AGorshkov101/RainDrop-Gaming-Keypad/README.md

# RainDrop Ergonomic Gaming Keypad
## Your Controls, Right Where You Need Them.

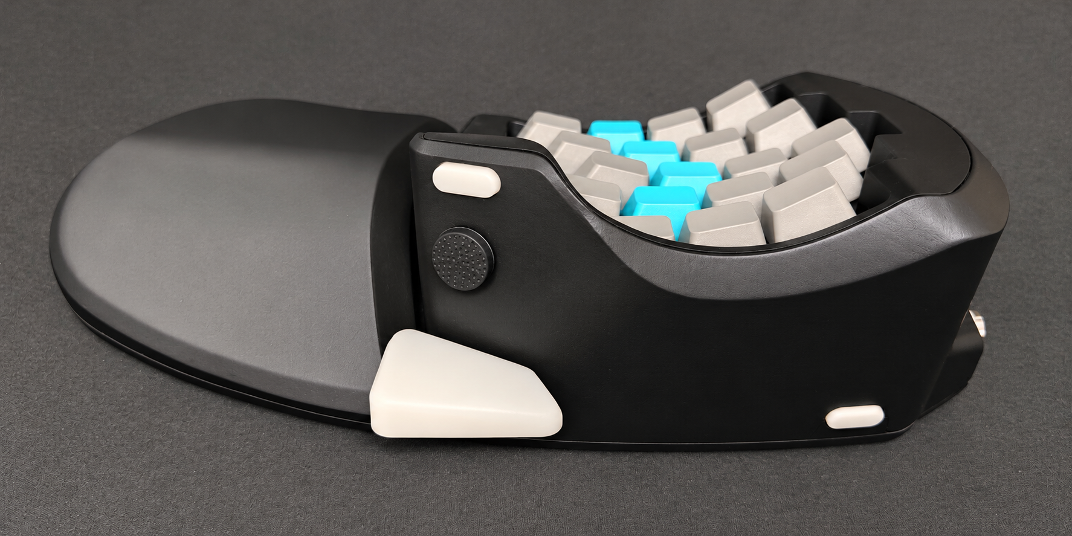
[picture p1: Images/Ergonomic Keypad.png]


**Curved Key Configuration**\
Follows the natural range of motion of your fingers to minimize stretching and keep every key within comfortable reach. 

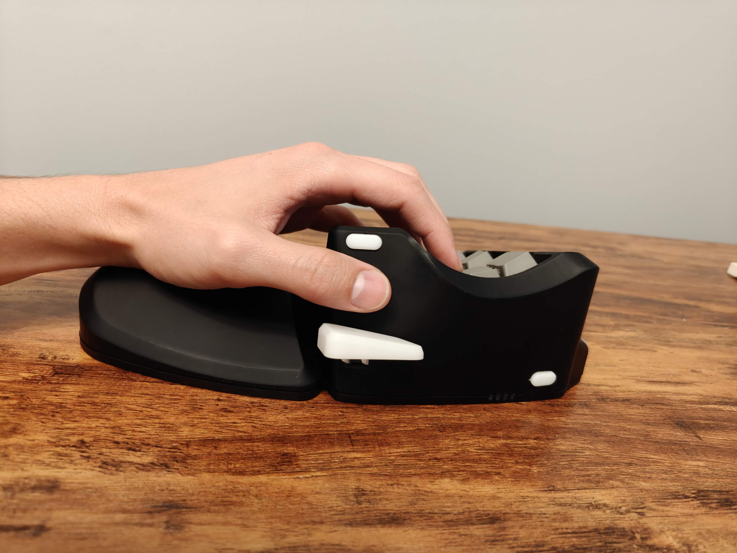
[picture p2: Images/IMG20260822131359.jpg]
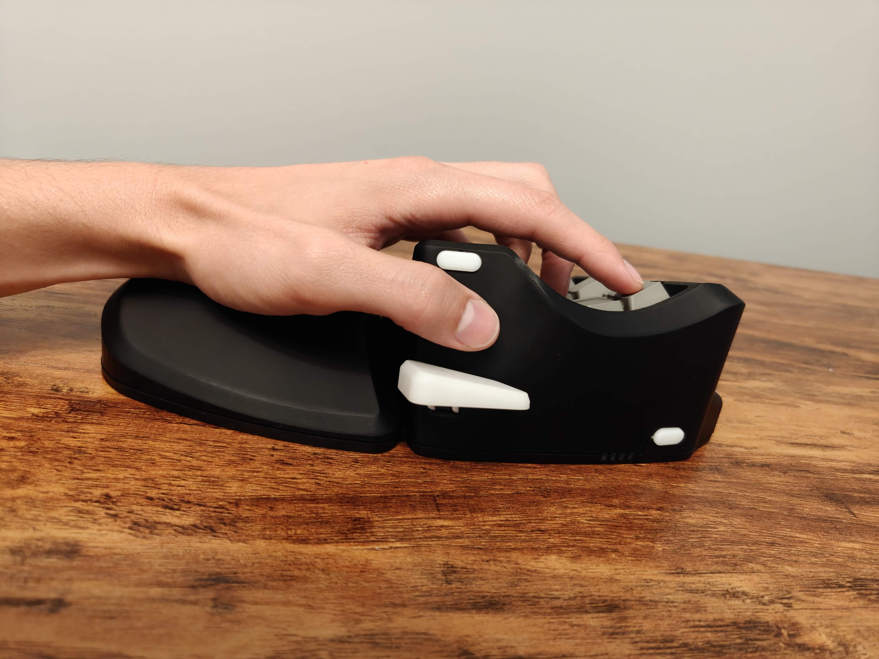
[picture p3: Images/IMG20260822131403.jpg]


**Finger-Aligned Key Layout**\
An intuitive linear layout with keys shifted to match the natural differences in finger length.

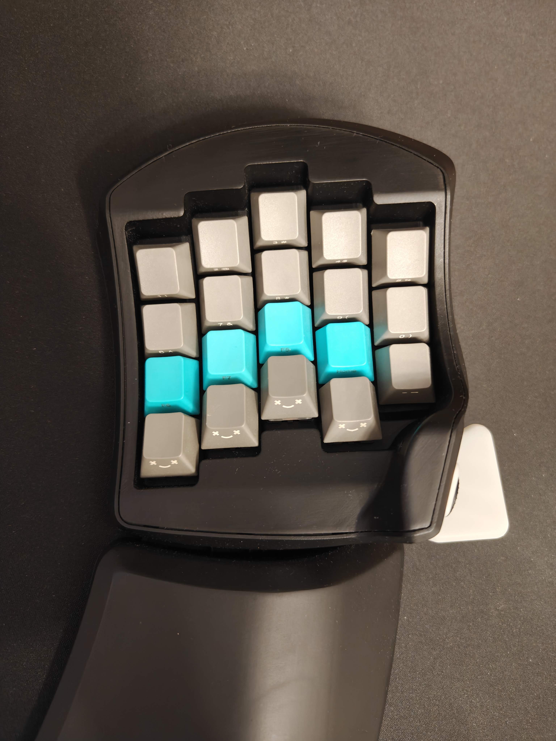
[picture p4: Images/IMG20261107213127.jpg]


**Compact Thumb Cluster**\
Designed to keep thumb keys within natural reach, minimizing excessive stretching to reducing thumb strain. 

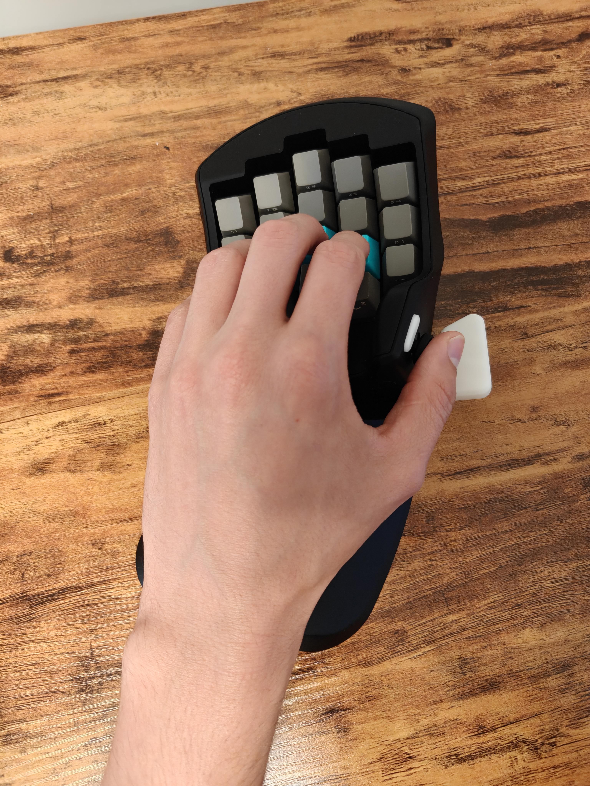
[picture p5: Images/IMG20260822131439.jpg]


**Natural Wrist Position**\
Angled to better align with your neutral wrist position for a more comfortable gaming experience.

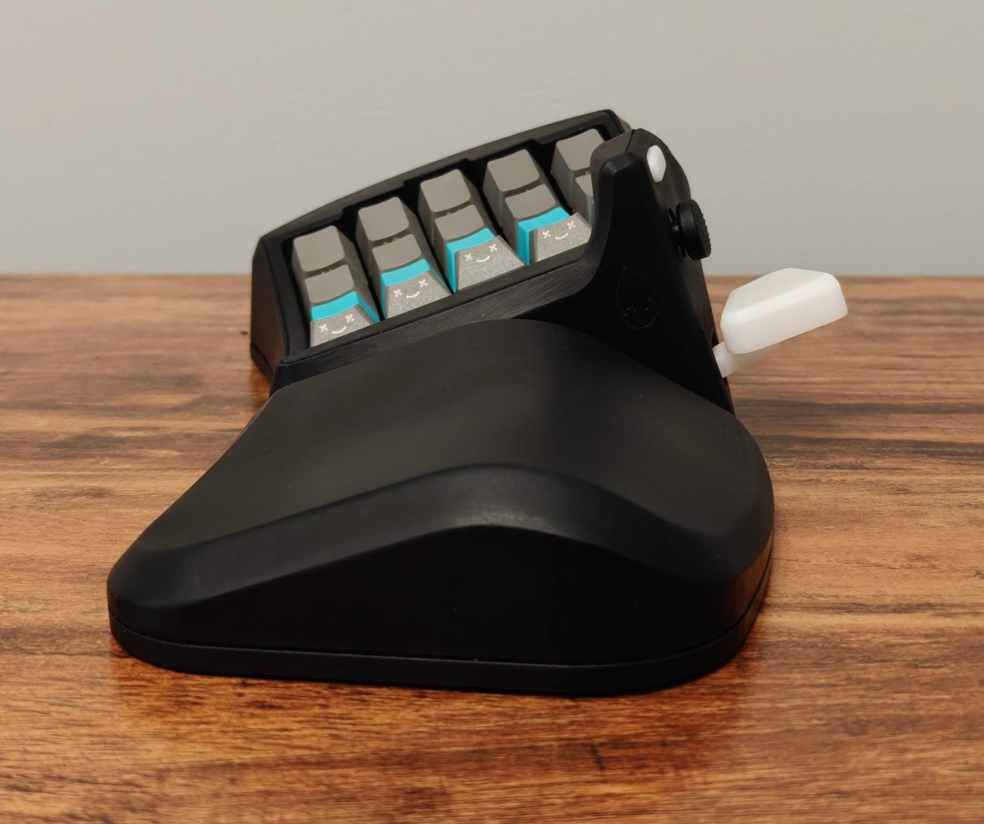
[picture p6: Images/IMG20260822131346.jpg]


**More Room to Aim**\
Compact design frees up valuable mouse space, giving you greater range of motion for low-sensitivity aiming.

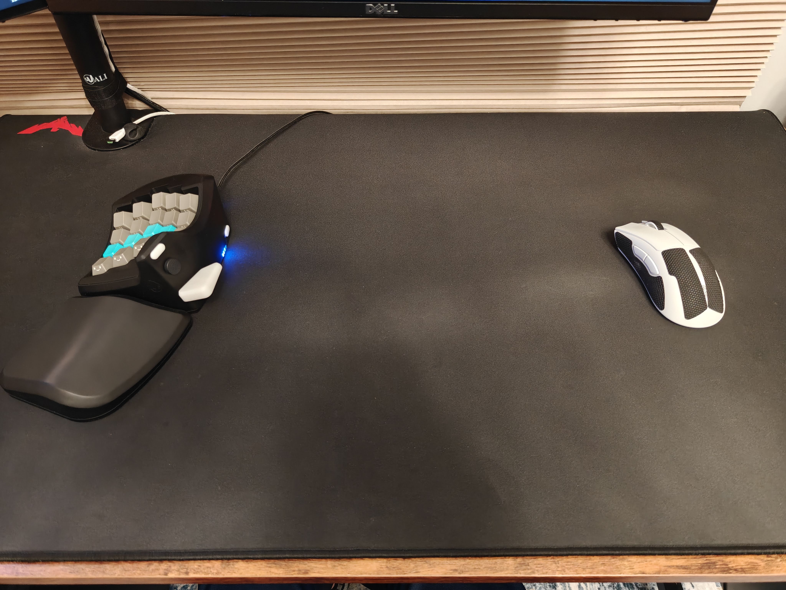
[picture p7: Images/IMG20261107213441.jpg]


**Customizable Mechanical Switches**\
Choose the mechanical switches that match your preferred feel, tactile feedback, and responsiveness.

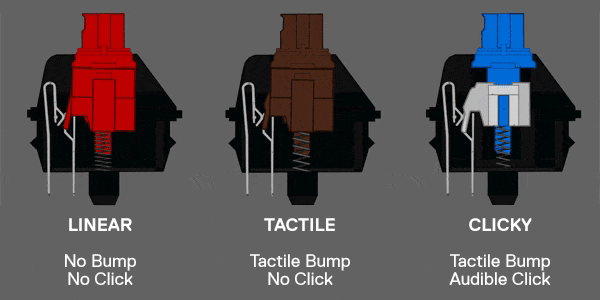
[picture p8: Images/Switch.png]


**Intuitive Configuration Software**\
Easily customize your key layout through a simple PC interface. Save up to four profiles directly to the device.

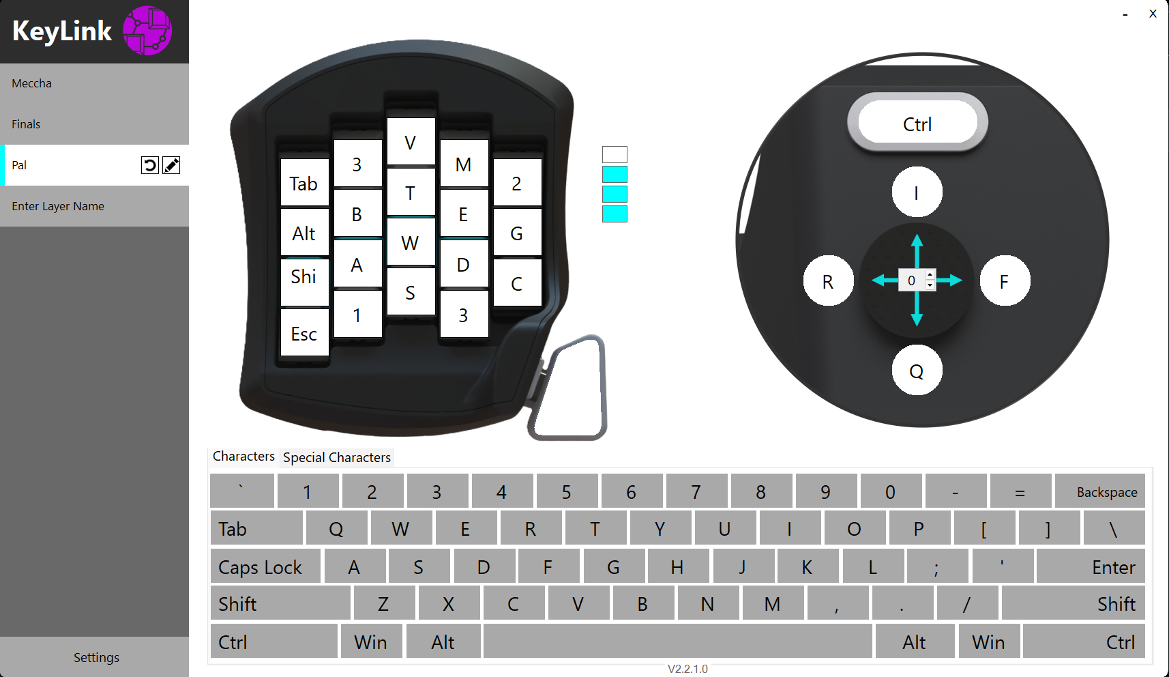
[picture p9: Images/ui.PNG]


**Fully Open Source**\
Make it your own. Explore, modify, customize, and build upon the design with complete access to the source.
