AGorshkov101/RainDrop-Gaming-Keypad/Images/20241106_225428.jpg

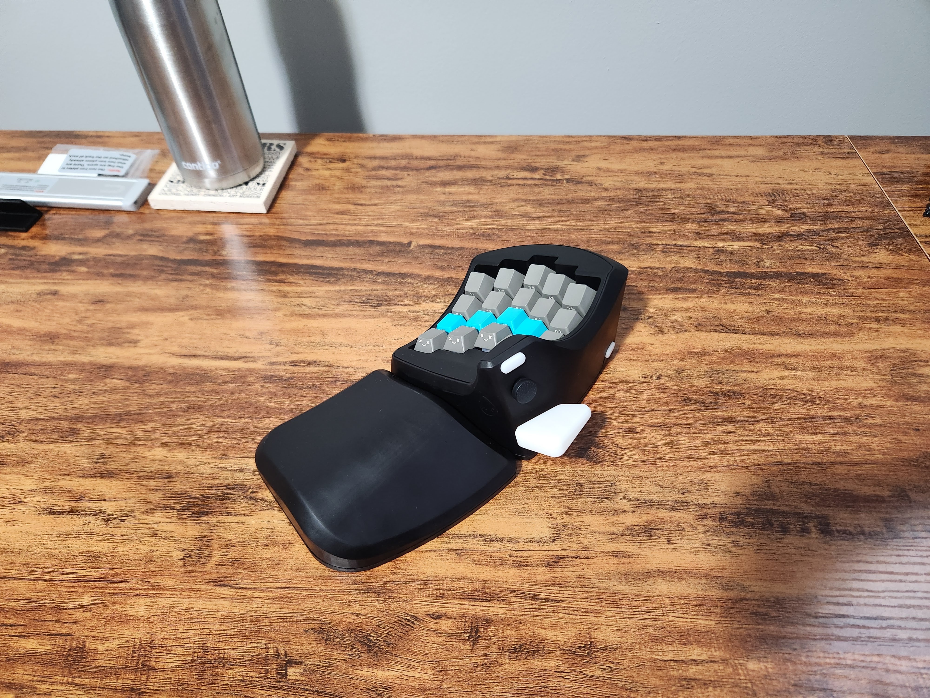
Images/20241106_225428.jpg
