AGorshkov101/RainDrop-Gaming-Keypad/Images/IMG20261107213005.jpg

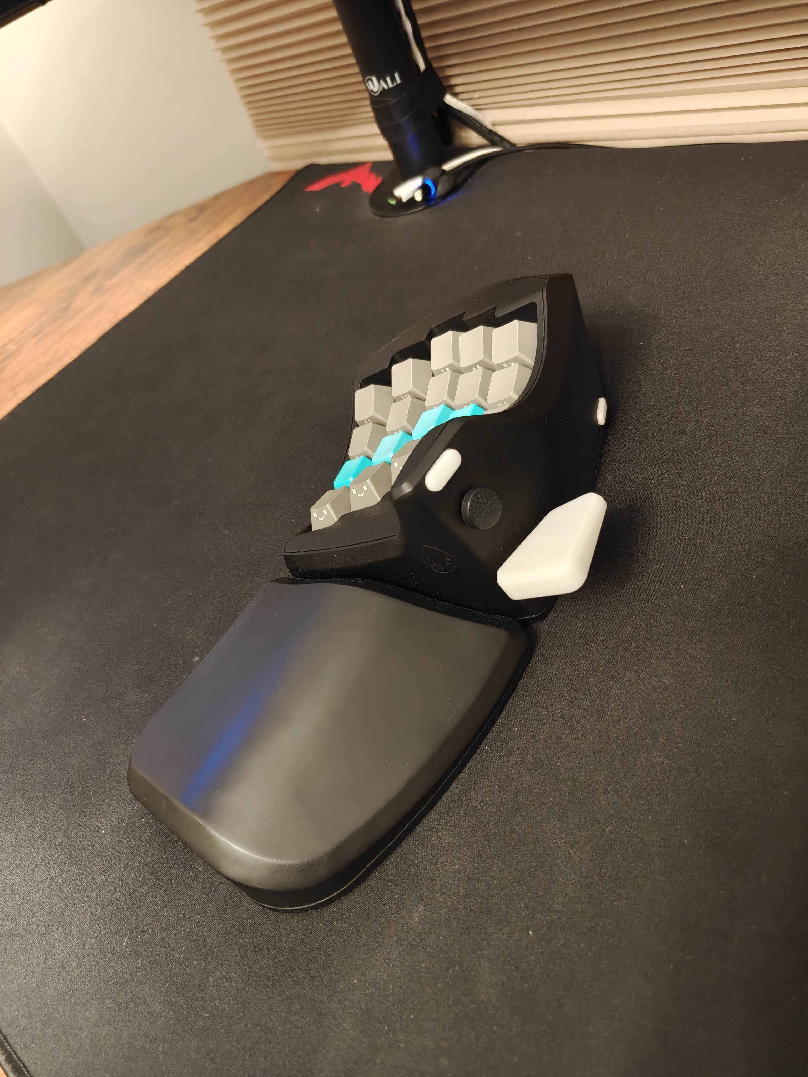
Images/IMG20261107213005.jpg
