AGorshkov101/RainDrop-Gaming-Keypad/Images/IMG20261107214502.jpg

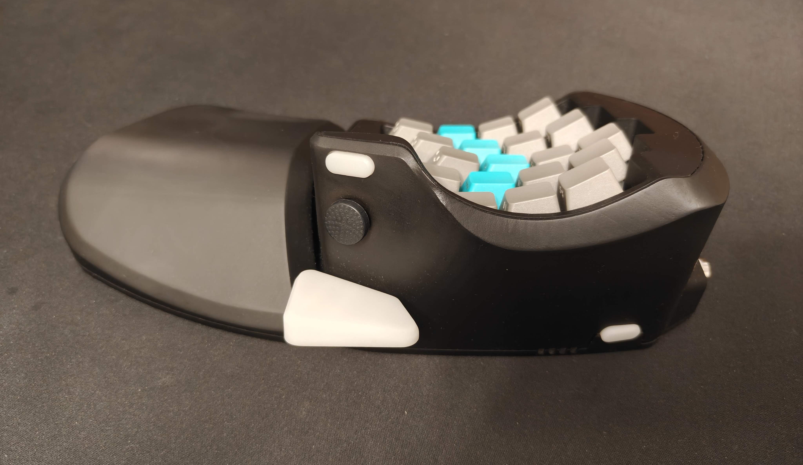
Images/IMG20261107214502.jpg
