AGorshkov101/RainDrop-Gaming-Keypad/Images/IMG_20261107_214522.jpg

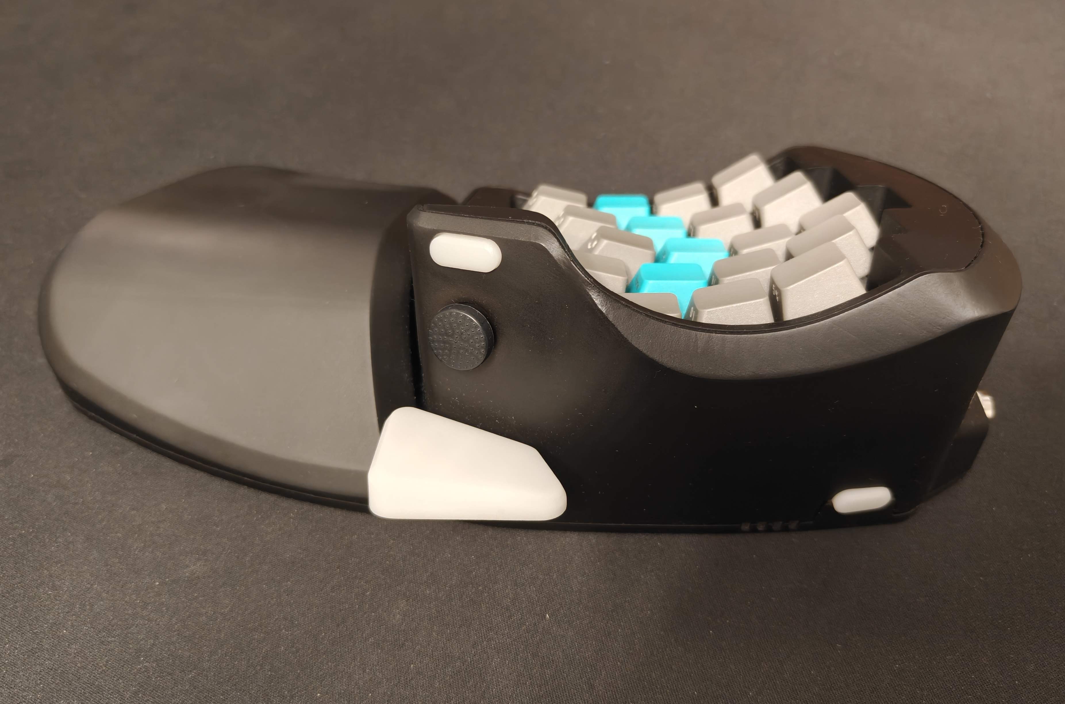
Images/IMG_20261107_214522.jpg
