AGorshkov101/RainDrop-Gaming-Keypad/Software/SerialToArduino V1/SerialToArduino/bin/Release/Resources/0_deg.png

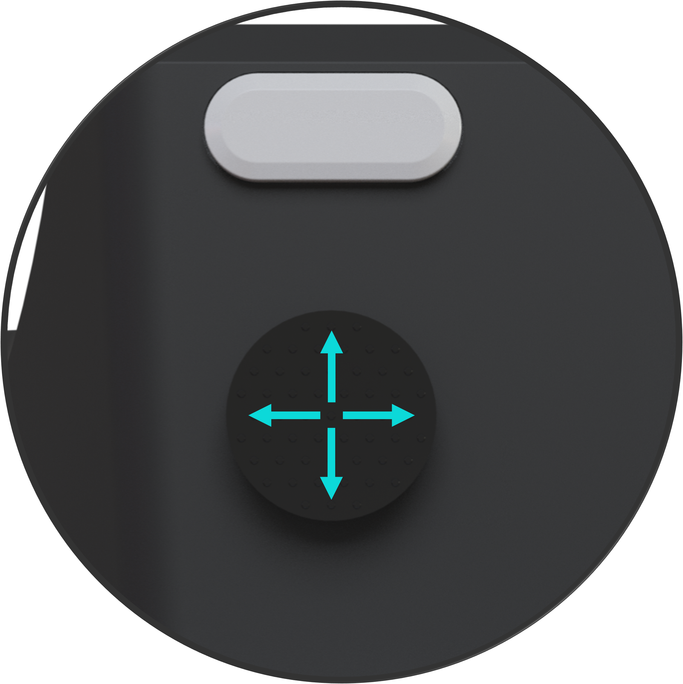
Software/SerialToArduino V1/SerialToArduino/bin/Release/Resources/0_deg.png
