AGorshkov101/RainDrop-Gaming-Keypad/Mechanical/Keypad BOM.xlsx

Sheet: Mech E BOM
Mechanical BOM
ITEM NO. | PART NUMBER | DESCRIPTION | QTY. | SOURCE | Link | Notes
1 | RD001 | BASE HOUSING | 1 | JLC3DP | https://jlc3dp.com/ | 3D print in black SLA recommended. Do not use FDM
2 | RD002 | LAYER BUTTON | 1 | JLC3DP | https://jlc3dp.com/ | 3D print in black SLA recommended. Do not use FDM
3 | RD003 | LAYER LIGHT PIPE | 1 | JLC3DP | https://jlc3dp.com/ | 3D print in black SLA recommended. Do not use FDM
4 | RD004 | OUTER MAIN HOUSING | 1 | JLC3DP | https://jlc3dp.com/ | 3D print in black SLA recommended. Do not use FDM
5 | RD005 | THUMB BRACKET | 1 | JLC3DP | https://jlc3dp.com/ | 3D print in black SLA recommended. Do not use FDM
6 | RD006 | THUMB SWITCH | 1 | JLC3DP | https://jlc3dp.com/ | 3D print in black SLA recommended. Do not use FDM
7 | RD007 | THUMB BUTTON | 1 | JLC3DP | https://jlc3dp.com/ | 3D print in black SLA recommended. Do not use FDM
8 | RD008 | KEY MOUNT HOUSING | 1 | JLC3DP | https://jlc3dp.com/ | 3D print in black SLA recommended. Do not use FDM
9 | RD009 | WRIST REST | 1 | JLC3DP | https://jlc3dp.com/ | 3D print in black SLA recommended. Do not use FDM
10 | 94035A139 | 18-8 STAINLESS STEEL PRECISION SHOULDER SCREW | 1 | McMaster | https://www.mcmaster.com/94035A139/
11 | N/A | R4 KEY CAP | 19 | Amazon | https://www.amazon.com/Elacgap-Profile-switches-Mechanical-Keyboard/dp/B0CQ2Y1CFL | You can source your own alternatives for aesthetic purposes. I recommend using the R4 row keycaps only
12 | N/A | MICRO USB Cable | 1 |  |  | Any cable that can you both data and power that you have laying around will do. Don’t bother purchasing
13 | N/A | JOY STICK CAP | 1 | Amazon | https://a.co/d/6ZMyECf | Optional purchase but recommended with many alternatives that you can source.
14 | 99512A153 | Thread-Forming Screw, Number 2 Size, 1/4" Long | 14 | McMaster | https://www.mcmaster.com/99512A153/
15 | N/A | BUMPER FOOT | 6 | Amazon | https://a.co/d/5e6TIrr
16 | N/A | All PCBAs | 1 | JLCPCB |  | See PCBA Tab

Sheet: PCBAs BOM
PCBA BOM
ID | Description | QTY | Manufacturer Part | Manufacturer | Supplier | Supplier Part | link
1 | Diode | 19 | 1N4148WS | Diotec Semiconductor | Digi-Key | C57759 | https://www.digikey.com/en/products/detail/diotec-semiconductor/1N4148WS/18833654
2 | Layer Button | 1 | TL1105RF160Q | E-Switch | Digi-Key | C273481 | https://www.digikey.com/en/products/detail/e-switch/TL1105RF160Q/13531
3 | LED-Blue(0805) | 4 | B1701NB--20D000114U1930 | Harvatek Corporation | Digi-Key | C72035 | https://www.digikey.com/en/products/detail/harvatek-corporation/B1701NB-20D000114U1930/16671748
4 | Resistor 330k | 4 | CRGCQ1206F330K | TE Connectivity Passive Product | Digi-Key |  | https://www.digikey.com/en/products/detail/te-connectivity-passive-product/CRGCQ1206F330K/8576442
5 | Reset Switch | 1 | PTS 647 SK70 SMTR2 LFS | C&K | Digi-Key | C28777 | https://www.digikey.com/en/products/detail/c-k/PTS-647-SK70-SMTR2-LFS/9649856
6 | Mechanical Switches | 19 |  | GATERON | Amazon | 540-MX1A-11NW | https://www.amazon.com/Pre-lubed-Switches-Mechanical-Keyboard-Pcs-5pin/dp/B0CKTHDDMB
7 | ARDUINO_PRO_MICRO | 1 | AITRIP | Pro Micro Atmega32U4 5V 16MHz | Amazon |  | https://www.amazon.com/AITRIP-ATmega32U4-arduino-Leonardo-ATmega328/dp/B08BJTS2N8
8 | Thumb Tactile Switches | 2 | D2LS-21 | Omron Electronics Inc-EMC Div | Digi-Key |  | https://www.digikey.com/en/products/detail/omron-electronics-inc-emc-div/D2LS-21/5031942
9 | CONN HEADER R/A 9POS 1.5MM | 2 | S9B-ZR(LF)(SN) | JST Sales America Inc. | Digi-Key | 455-1676-ND | https://www.digikey.com/en/products/detail/jst-sales-america-inc/S9B-ZR/926583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
10 | CONN HEADER R/A 6POS 1.5MM | 2 | S6B-ZR(LF)(SN) | JST Sales America | Digi-Key | C265407 | https://www.digikey.com/en/products/detail/jst-sales-america-inc/S6B-ZR/926580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
11 | Micro PCB | 1 | N/A | N/A | JLCPCB |  | https://jlcpcb.com/
12 | Joy PCB | 1 | N/A | N/A | JLCPCB |  | https://jlcpcb.com/
13 | SWITCH FLEX PCB | 1 | N/A | N/A | JLCPCB |  | https://jlcpcb.com/
14 | Joystick | 1 | 2765 | Adafruit Industries LLC | Digi-Key |  | http://www.digikey.com/product-detail/en/2765/1528-1730-ND/6193582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
15 | Cable to Joystick | 1 | A06ZR06ZR28H152B | JST Sales America Inc. | Digi-Key |  | https://www.digikey.com/en/products/detail/jst-sales-america-inc/A06ZR06ZR28H152B/6009415
16 | Cable to Switches | 1 | A09ZR09ZR28H152A | JST Sales America Inc. | Digi-Key |  | https://www.digikey.com/en/products/detail/jst-sales-america-inc/A09ZR09ZR28H152A/6708535
