AGorshkov101/RainDrop-Gaming-Keypad/Mechanical/STL/Outer Main Housing.STL

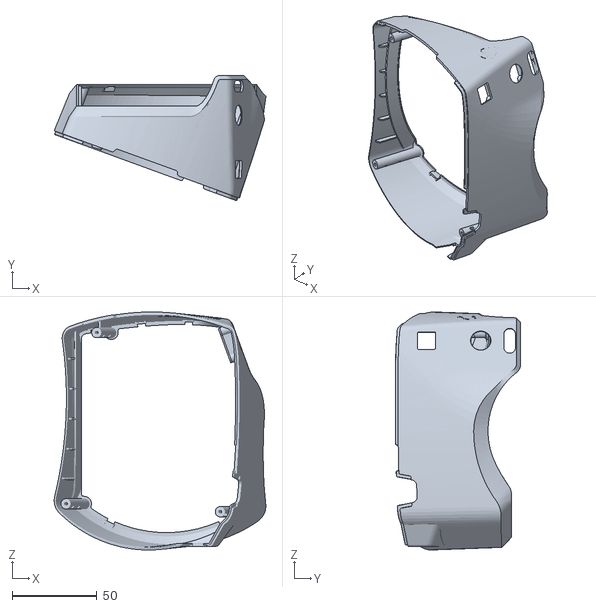
[picture p18: CAD file, 2026-11-08]
Mechanical/STL/Outer Main Housing.STL
124.7 x 73.9 x 140.2
