AGorshkov101/RainDrop-Gaming-Keypad/Mechanical/STL/Layer Light Pipe.STL

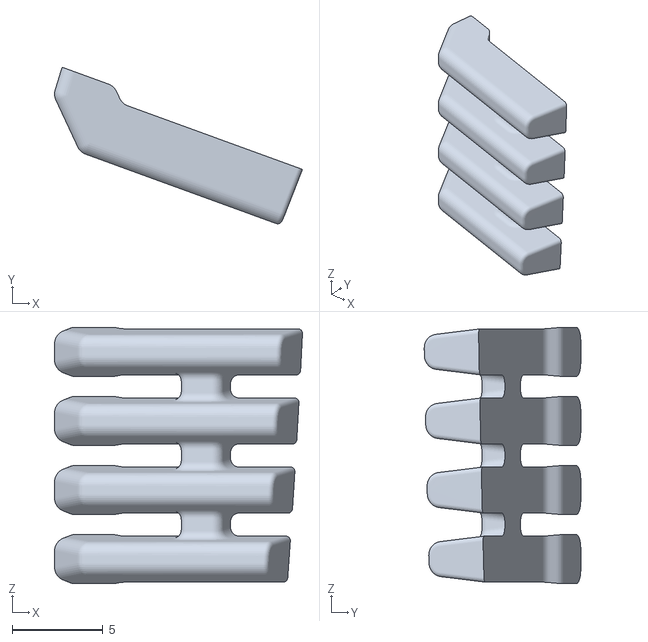
[picture p19: CAD file, 2026-11-08]
Mechanical/STL/Layer Light Pipe.STL
13.7 x 8.64 x 14.1
