AGorshkov101/RainDrop-Gaming-Keypad/Mechanical/STL/Key Mount Housing.STL

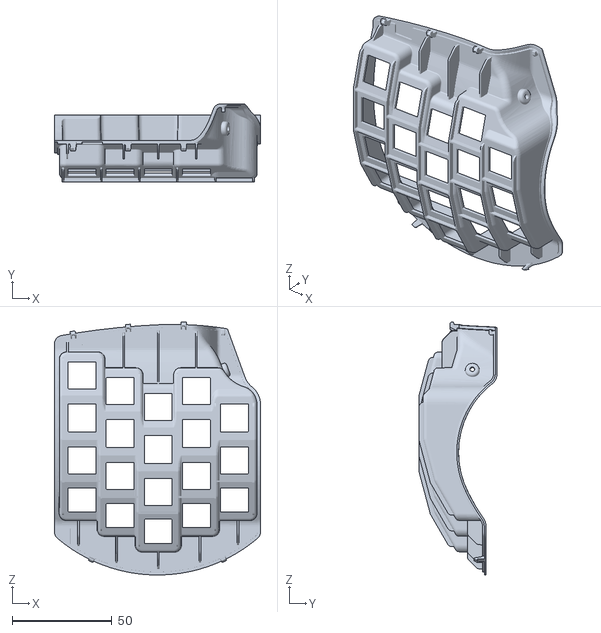
[picture p20: CAD file, 2026-11-08]
Mechanical/STL/Key Mount Housing.STL
103.2 x 39.1 x 126.6
