AGorshkov101/RainDrop-Gaming-Keypad/Mechanical/STL/Wrist Rest.STL

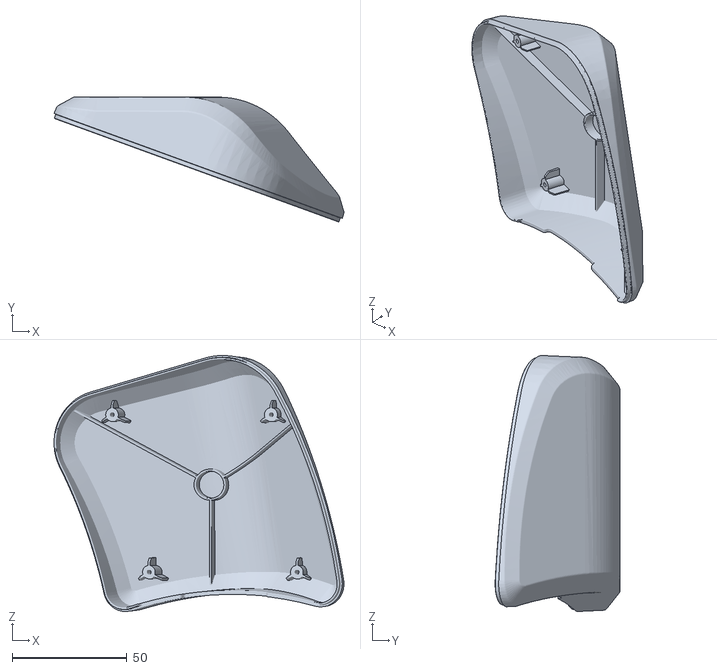
[picture p21: CAD file, 2026-11-08]
Mechanical/STL/Wrist Rest.STL
126.3 x 54.3 x 111.5
