AGorshkov101/RainDrop-Gaming-Keypad/Mechanical/STL/Layer Button.STL

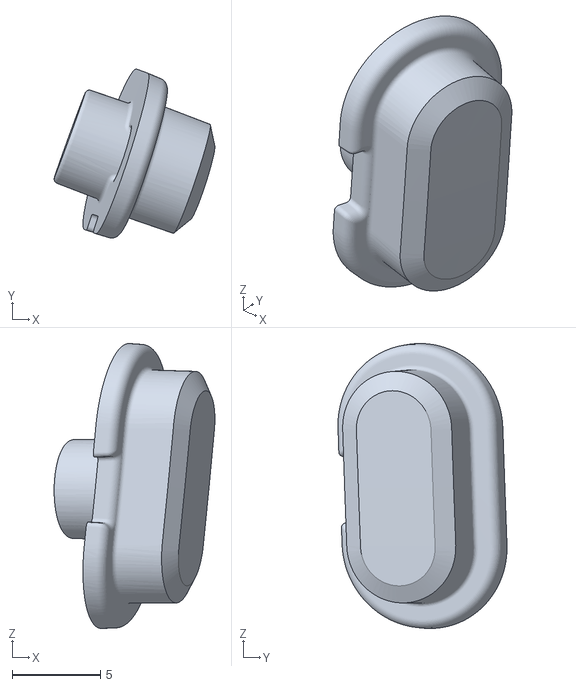
[picture p22: CAD file, 2026-11-08]
Mechanical/STL/Layer Button.STL
9.09 x 9.56 x 16.1
