AGorshkov101/RainDrop-Gaming-Keypad/Mechanical/STL/Base Housing.STL

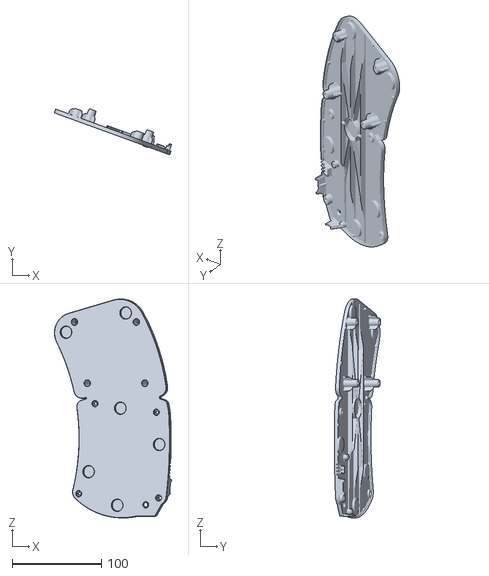
[picture p23: CAD file, 2026-11-08]
Mechanical/STL/Base Housing.STL
131.1 x 52.0 x 245.3
