AGorshkov101/RainDrop-Gaming-Keypad/Mechanical/STL/Thumb Button.STL

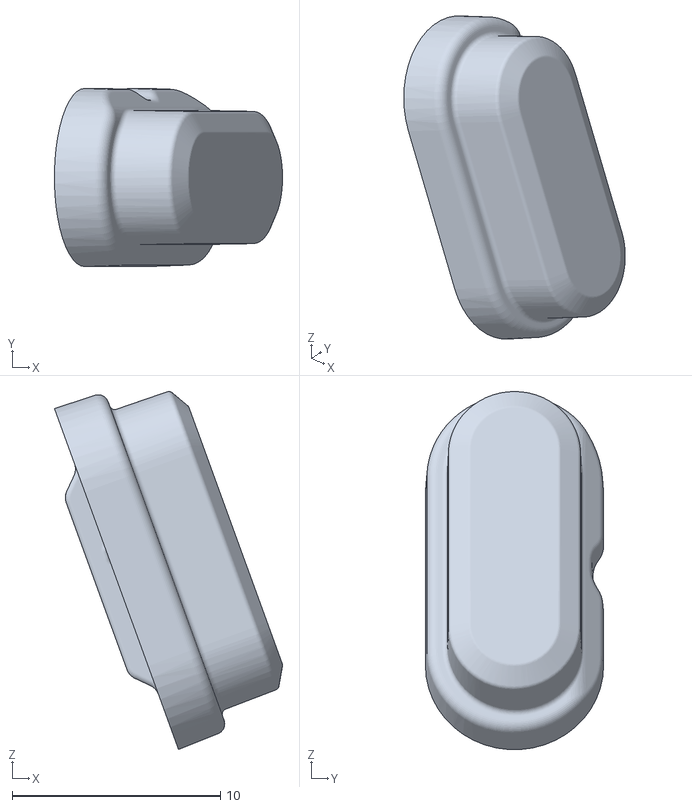
[picture p24: CAD file, 2026-11-08]
Mechanical/STL/Thumb Button.STL
11.0 x 8.56 x 17.2
