AGorshkov101/RainDrop-Gaming-Keypad/Mechanical/STL/Thumb Bracket.STL

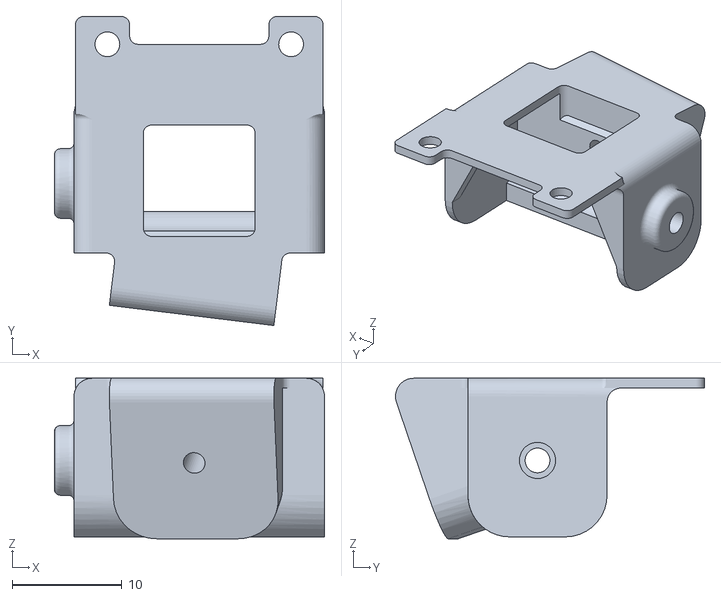
[picture p25: CAD file, 2026-11-08]
Mechanical/STL/Thumb Bracket.STL
24.6 x 28.2 x 14.6
