AGorshkov101/RainDrop-Gaming-Keypad/Mechanical/STL/Thumb Switch.STL

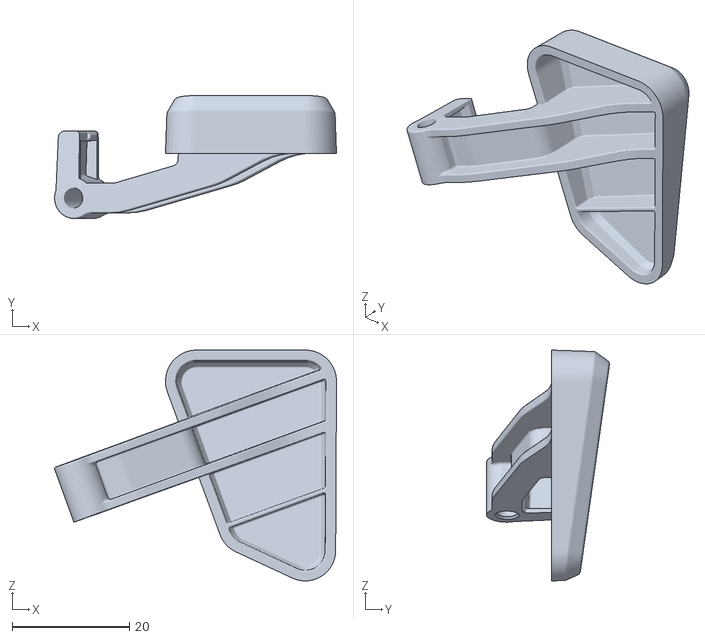
[picture p26: CAD file, 2026-11-08]
Mechanical/STL/Thumb Switch.STL
48.1 x 21.0 x 39.4
