AGorshkov101/RainDrop-Gaming-Keypad/Electrical/Gerber/Gerber_Gaming_Keyboard_V5_JoyStick-PCB-Flex_2026-08-09/How-to-order-PCB.txt

How to Order PCB

Please refer to:
https://docs.easyeda.com/en/PCB/Order-PCB
