AGorshkov101/RainDrop-Gaming-Keypad/Electrical/Schematic_Gaming_Keyboard_V5.pdf

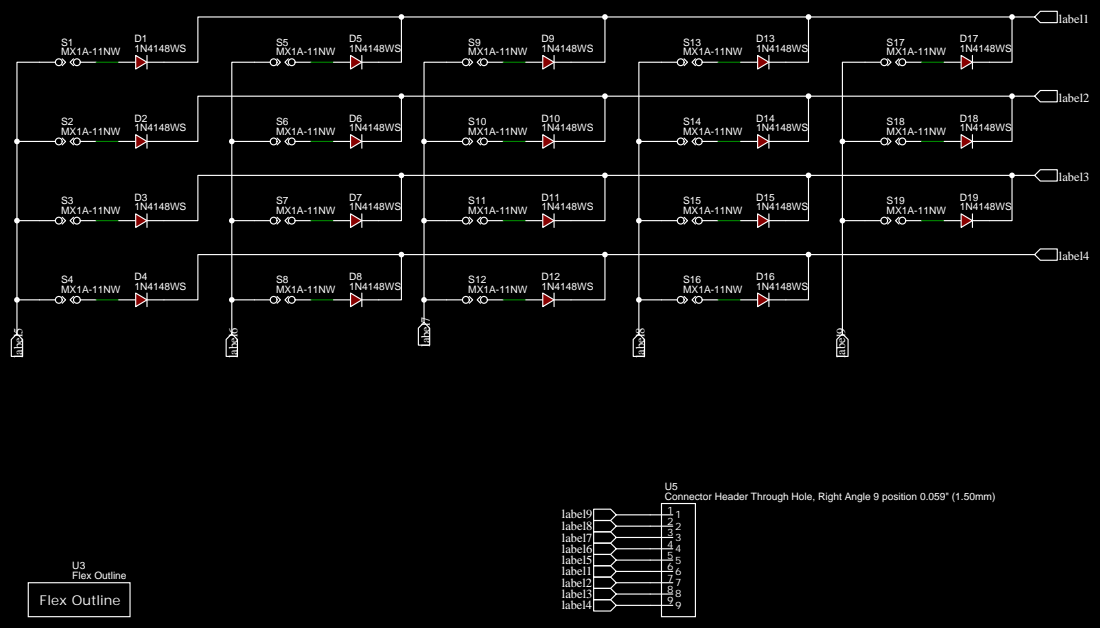
[picture p90: page 1]

jb_1

space

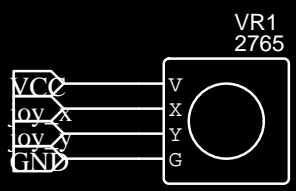
[picture p91: figure]
GVYX; GND; VCC joy_x joy_y

OMRON D2LS-21

U2

NO | COM

OMRON D2LS-21

U6

NO | COM

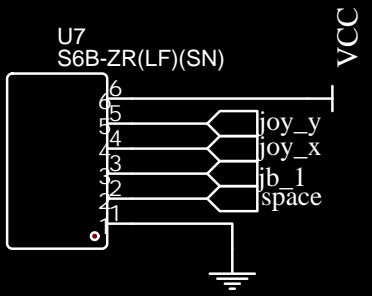
[picture p92: figure]
space; joy_x; joy_y; VCC

Joy PCB Flex

U10

### Joy PCB

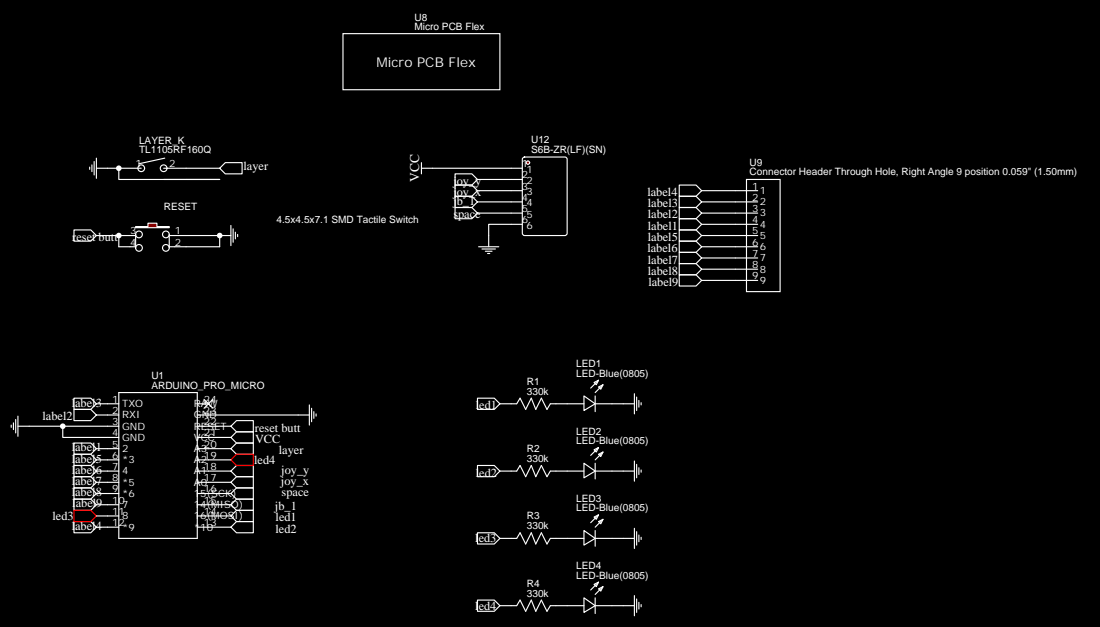
[picture p93: page 3]
