AGorshkov101/RainDrop-Gaming-Keypad/(list of files, drawings)

Other design files:
Electrical/EasyEda/1-PCB_Micro PCB Flex.json
Electrical/EasyEda/1-Schematic_Gaming_Keyboard_V5.json
Electrical/EasyEda/2-PCB_JoyStick PCB Flex.json
Electrical/EasyEda/3-PCB_Main PCB Flex.json
