AGorshkov101/RainDrop-Gaming-Keypad/Software/Keypad_V1.0.0/2_layer_select.ino

void layer_select(){

  int layer_state = digitalRead(layer_butt_pin);

  if ((layer_state == LOW) && ((millis() - last_layer_db) > layer_db_delay)) {
    
    last_layer_db = millis();

    selected_layer += 1;
    key_layer_update();

  }
}
