AGorshkov101/RainDrop-Gaming-Keypad/Software/Keypad_V1.0.0/3_kpd_check.ino

void kpd_check(){

  if (current_kpd.getKeys())
  {
      for (int i=0; i<LIST_MAX; i++)   // Scan the whole key list.
      {
          if ( current_kpd.key[i].stateChanged )   // Only find keys that have changed state.
          {
              switch (current_kpd.key[i].kstate) {  // Report active key state : IDLE, PRESSED, HOLD, or RELEASED
                  case PRESSED:
                  Keyboard.press(current_kpd.key[i].kchar);
              break;
                  case RELEASED:
                  Keyboard.release(current_kpd.key[i].kchar);
              }
          }
      }
  }
}
