AGorshkov101/RainDrop-Gaming-Keypad/(commit log)

2026-11-08 Add files via upload
    Assembly Instructions and EE files
    [1-PCB_Micro PCB Flex.json, 1-Schematic_Gaming_Keyboard_V5.json, 2-PCB_JoyStick PCB Flex.json, 3-PCB_Main PCB Flex.json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]
2026-11-08 Add files via upload
    Mech E files
    [Base Housing.STL, Key Mount Housing.STL, Layer Button.STL, Layer Light Pipe.STL, Outer Main Housing.STL, Thumb Bracket.STL, Thumb Button.STL, Thumb Switch.STL]
